adithya-in/esp-rc-link/(commit log)

2026-10-18 Initial commit: ESP32-C3 TX + ESP8266 RX PPM RC link
    - ESP-NOW link from ESP32-C3 transmitter to ESP8266 receiver
    - ArduPPM/APM2-compatible single-wire PPM output (rising-edge period == channel value)
    - Web Serial configurator with channel mapping and calibration
    - Loopback self-test and diagnostics
2026-10-23 Add SVG diagrams: architecture, PPM waveform, wiring
2026-10-24 Add tested ESP32-CAM live feed firmware and FPV camera docs
    [partitions.csv]
